stefanofinetti/MF_A320_Tiller/docs/img/button_heart.png

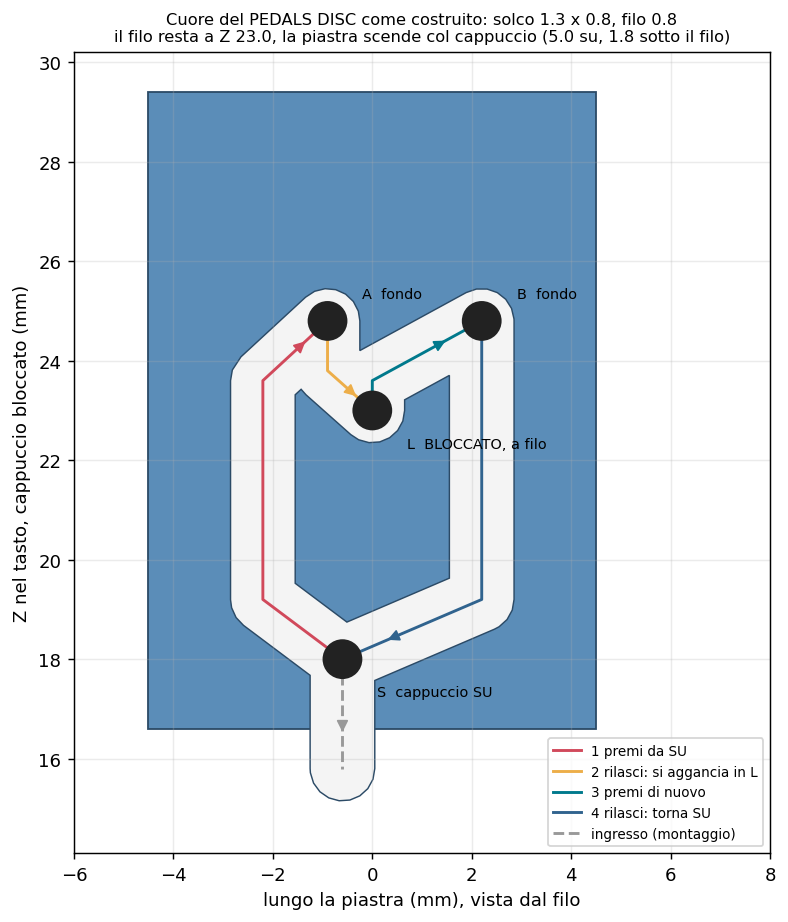
docs/img/button_heart.png
