stefanofinetti/MF_A320_Tiller/docs/img/button_legend.png

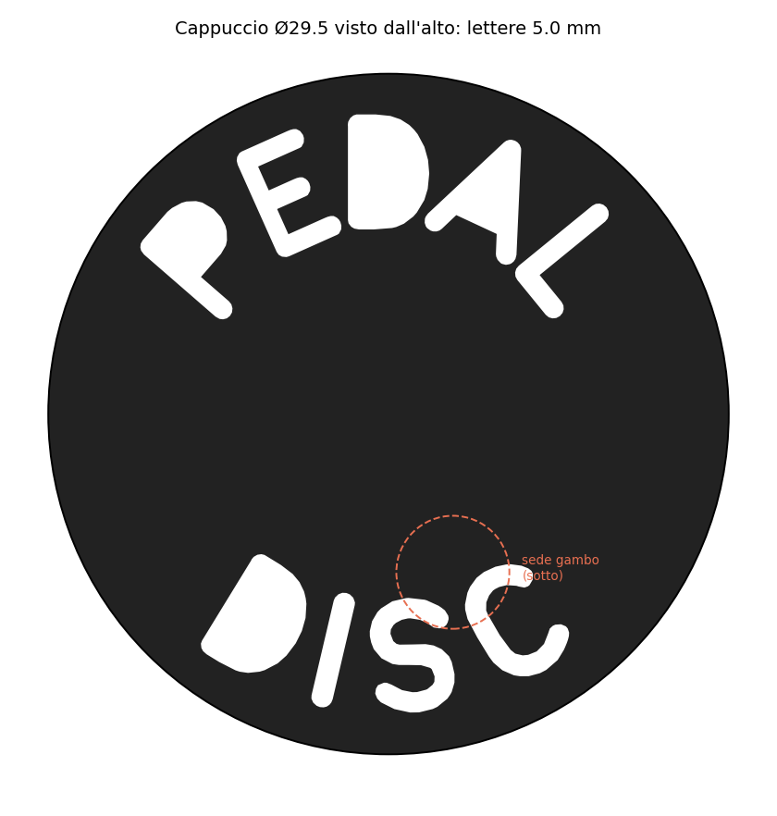
docs/img/button_legend.png
