stefanofinetti/MF_A320_Tiller/docs/img/button_switch.png

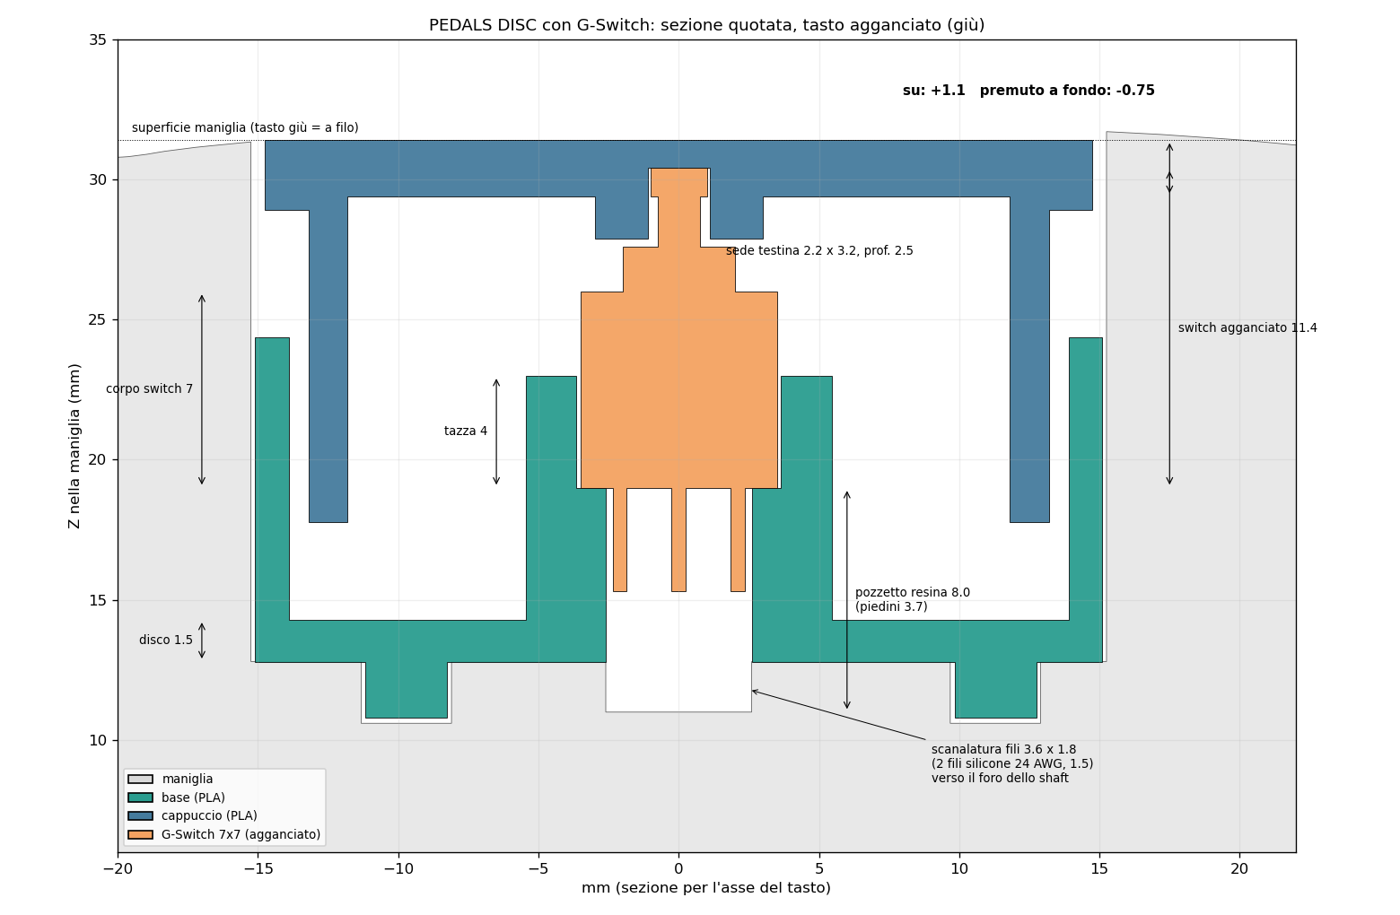
docs/img/button_switch.png
