stefanofinetti/MF_A320_Tiller/docs/img/case_layout_top.png

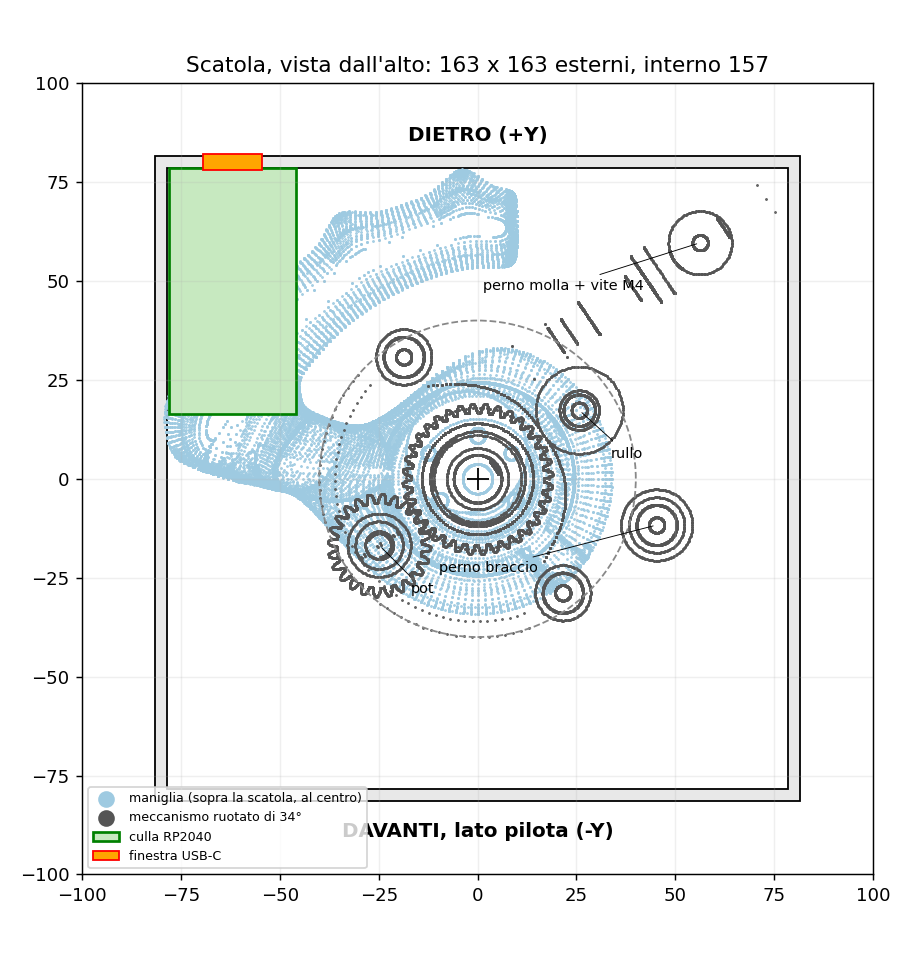
docs/img/case_layout_top.png
