stefanofinetti/MF_A320_Tiller/docs/img/case_sections.png

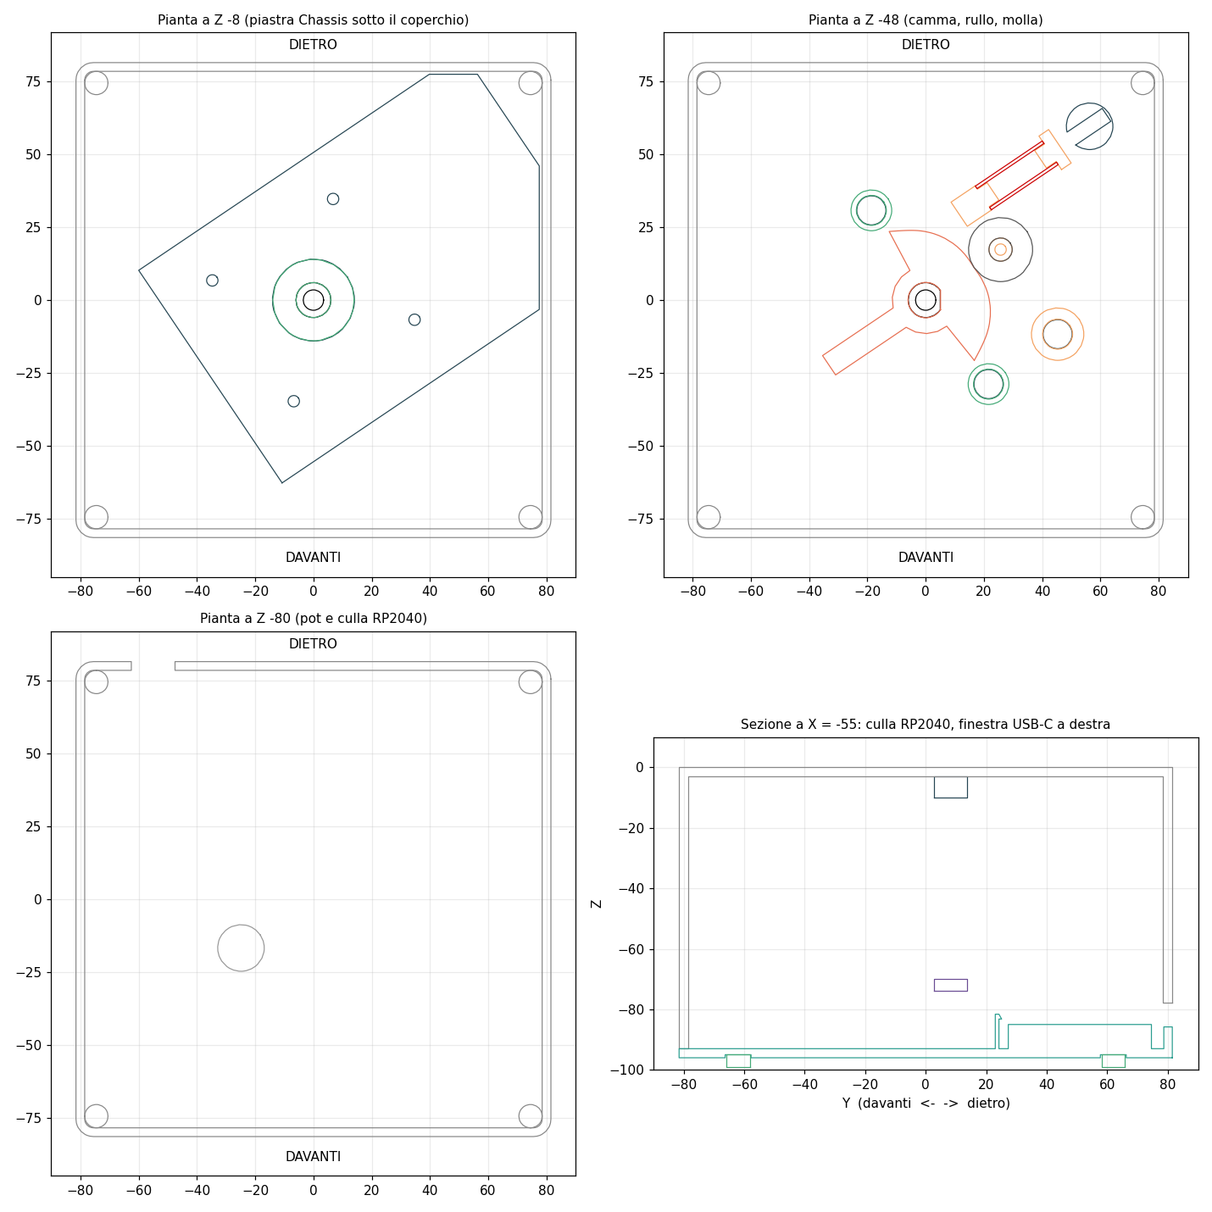
docs/img/case_sections.png
