stefanofinetti/MF_A320_Tiller/docs/img/IMG_1014.jpg

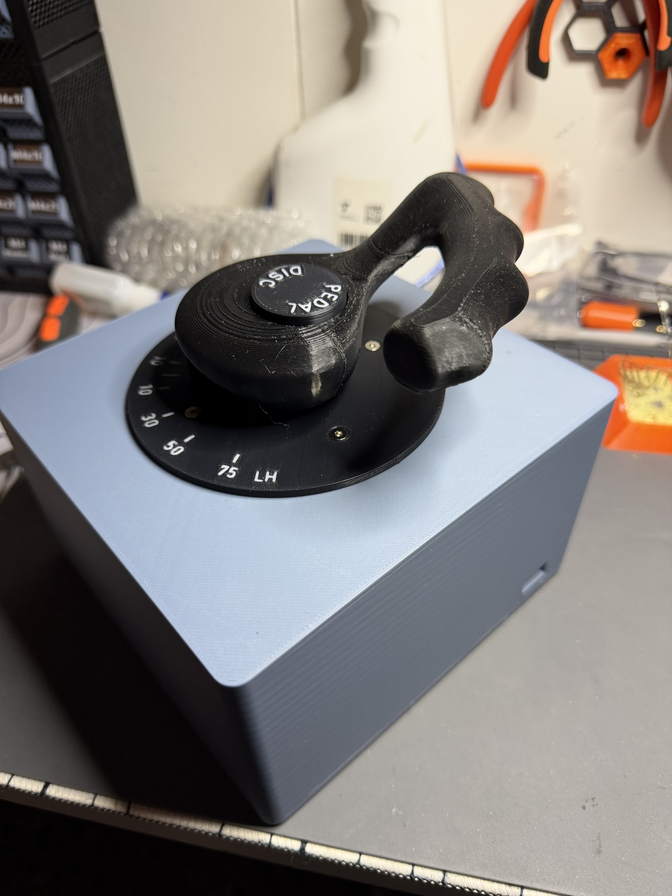
docs/img/IMG_1014.jpg
