stefanofinetti/MF_A320_Tiller/docs/img/mechanism_v2.png

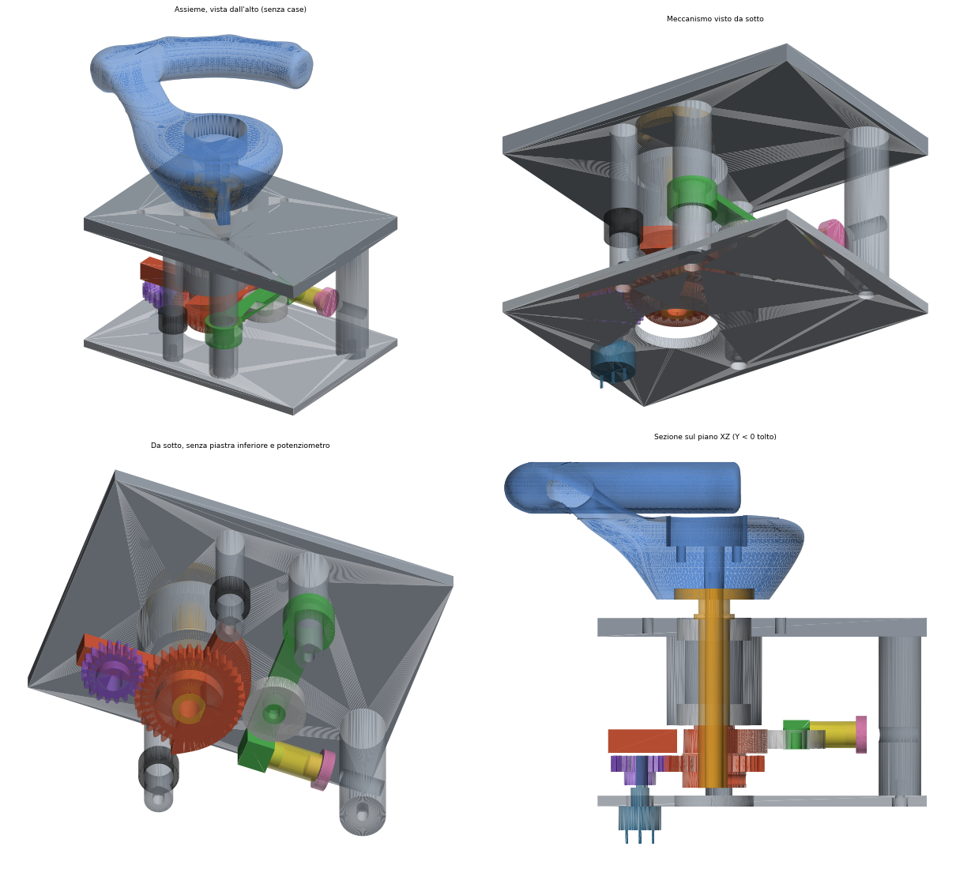
docs/img/mechanism_v2.png
