stefanofinetti/MF_A320_Tiller/docs/img/roller_pin.png

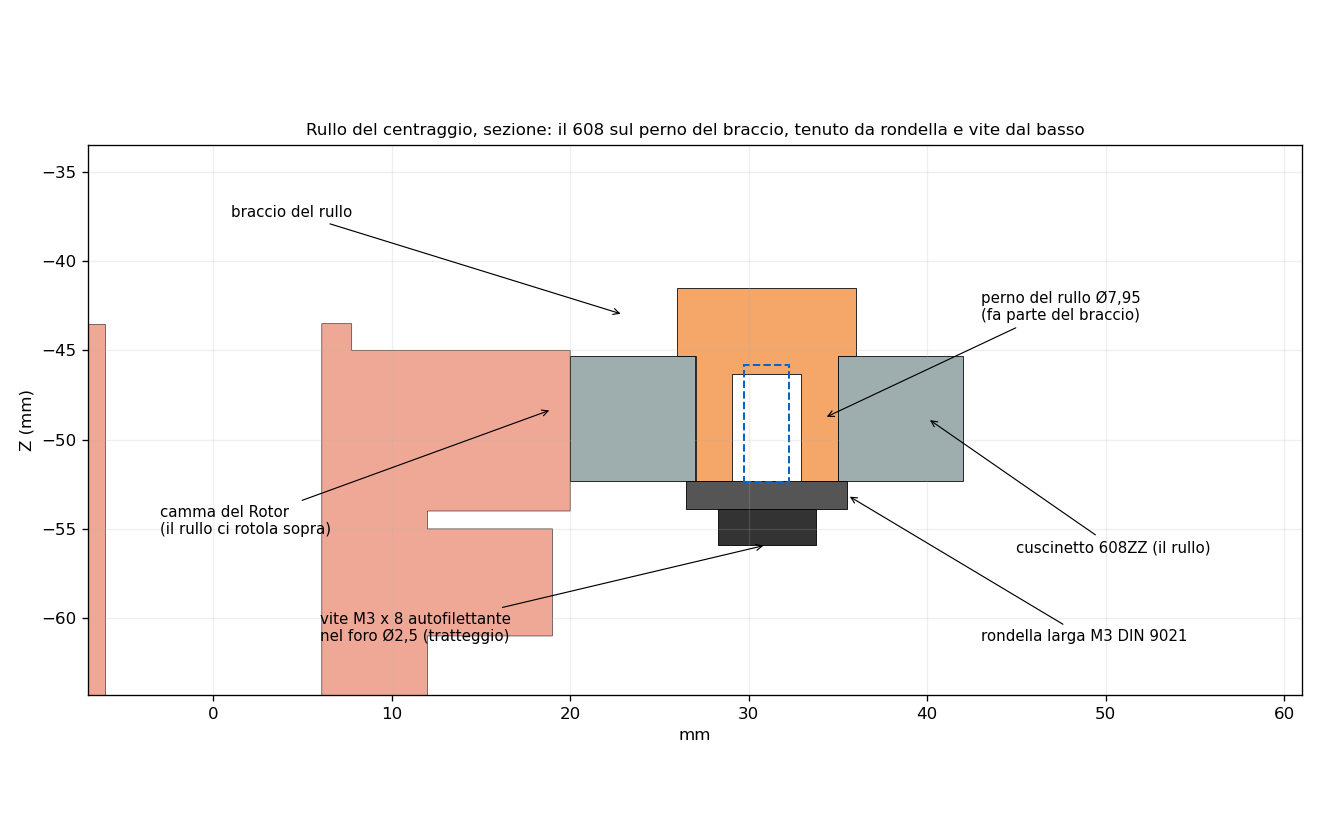
docs/img/roller_pin.png
