stefanofinetti/MF_A320_Tiller/docs/img/scale_disc.png

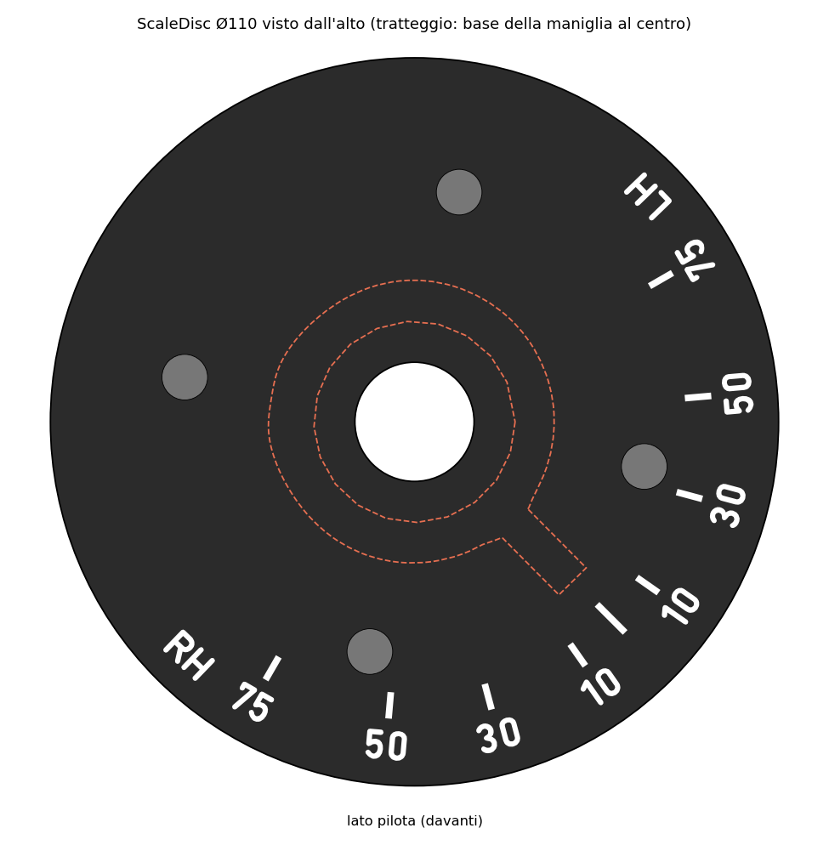
docs/img/scale_disc.png
