stefanofinetti/MF_A320_Tiller/cad/Hardware.FCStd

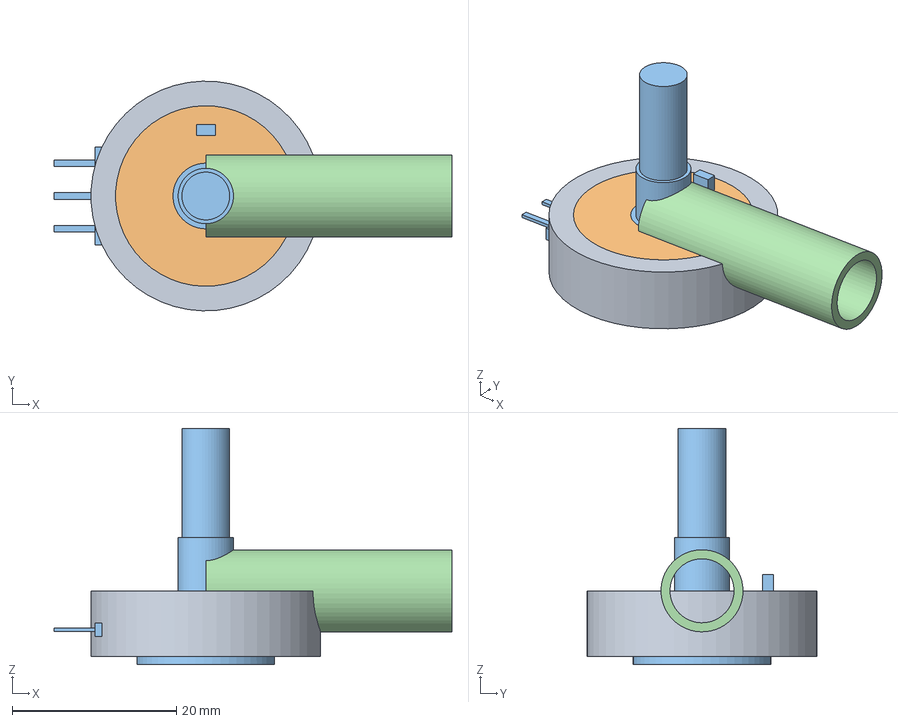
[picture p12: CAD file, 2026-11-09]
cad/Hardware.FCStd
48.5 x 28.0 x 28.8 mm
Bearing6001
Bearing608
Pot
Spring
