stefanofinetti/MF_A320_Tiller/stl/Tiller-SpringCup.stl

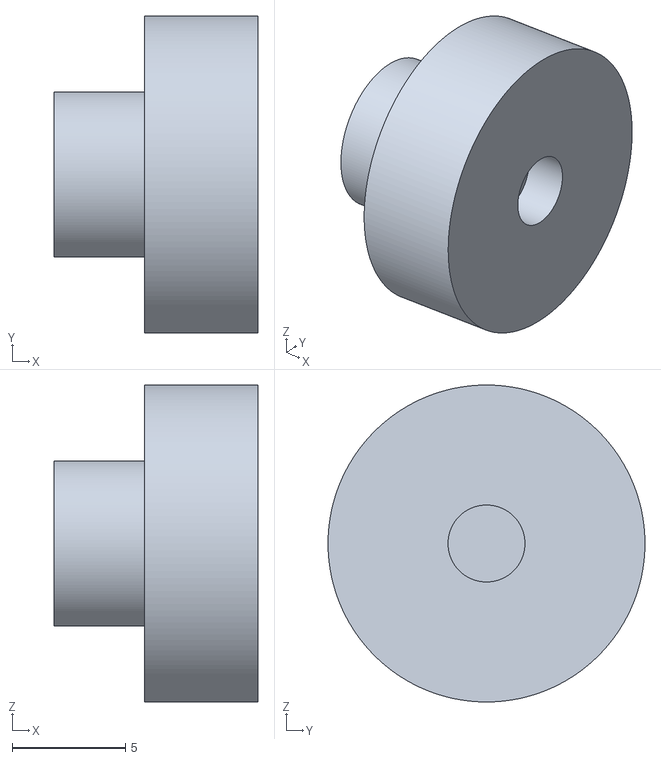
[picture p13: CAD file, 2026-11-09]
stl/Tiller-SpringCup.stl
9.00 x 14.0 x 14.0
