stefanofinetti/MF_A320_Tiller/cad/ScaleDisc.FCStd

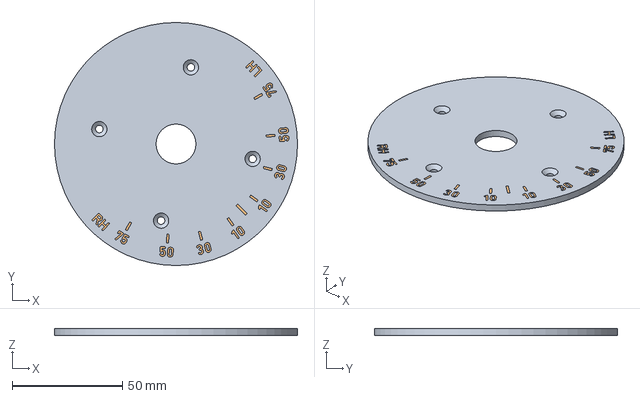
[picture p14: CAD file, 2026-11-09]
cad/ScaleDisc.FCStd
110.0 x 110.0 x 3.00 mm
ScaleDisc
ScaleDiscLegend
