stefanofinetti/MF_A320_Tiller/stl/Tiller-ButtonBase.stl

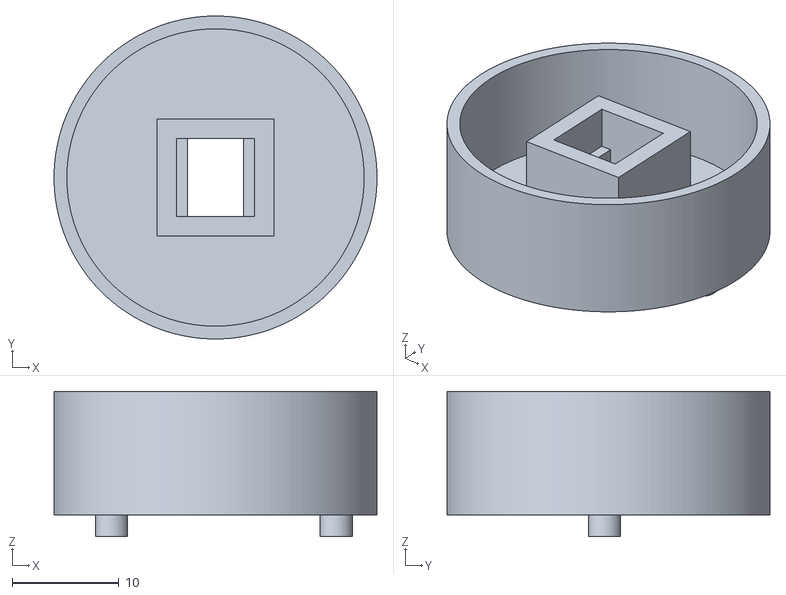
[picture p15: CAD file, 2026-11-09]
stl/Tiller-ButtonBase.stl
30.2 x 30.2 x 13.6
