stefanofinetti/MF_A320_Tiller/cad/ButtonBase.FCStd

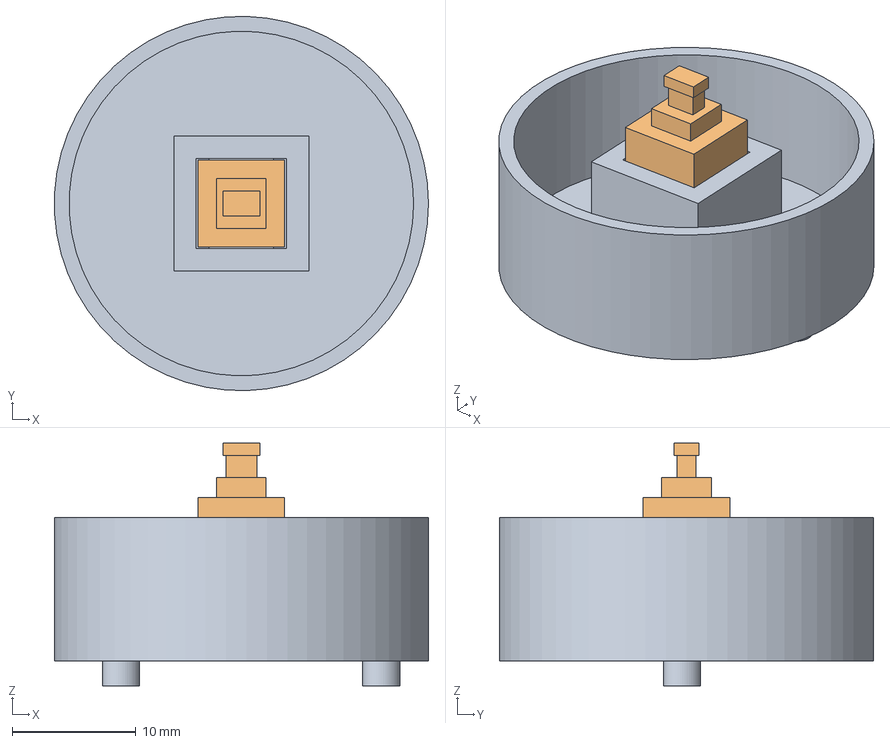
[picture p16: CAD file, 2026-11-09]
cad/ButtonBase.FCStd
30.2 x 30.2 x 19.6 mm
ButtonBase
Switch
