stefanofinetti/MF_A320_Tiller/stl/Tiller-CaseBottom.stl

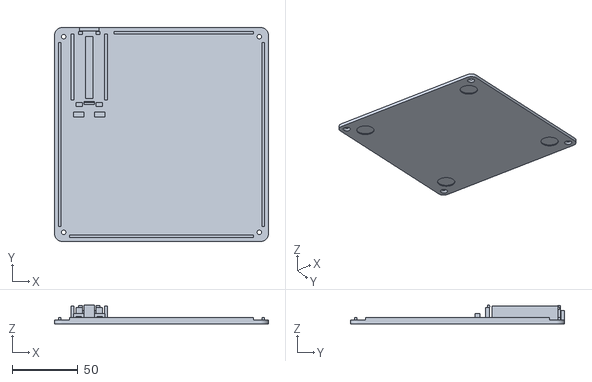
[picture p17: CAD file, 2026-11-09]
stl/Tiller-CaseBottom.stl
163.0 x 163.0 x 14.4
