stefanofinetti/MF_A320_Tiller/cad/Chassis.FCStd

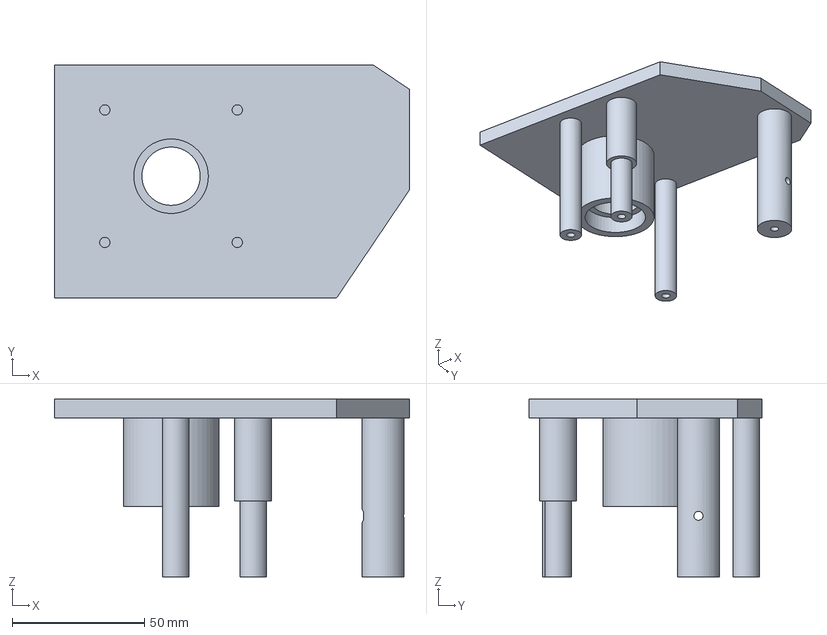
[picture p18: CAD file, 2026-11-09]
cad/Chassis.FCStd
134.0 x 88.0 x 67.0 mm
