stefanofinetti/MF_A320_Tiller/stl/Tiller-Handle.stl

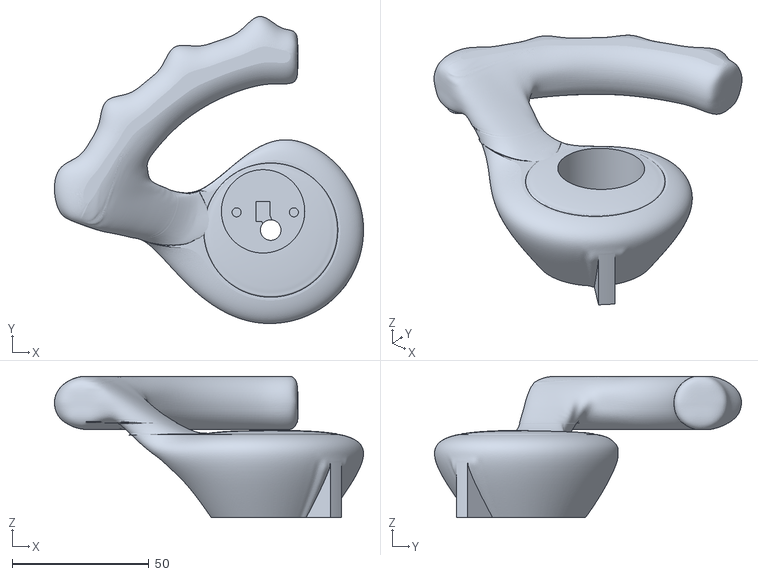
[picture p19: CAD file, 2026-11-09]
stl/Tiller-Handle.stl
113.1 x 112.4 x 51.8
