stefanofinetti/MF_A320_Tiller/cad/Bumper.FCStd

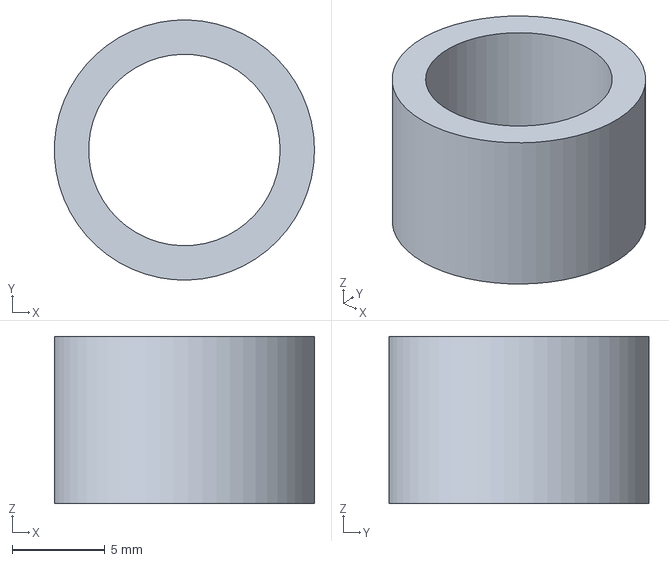
[picture p20: CAD file, 2026-11-09]
cad/Bumper.FCStd
14.0 x 14.0 x 9.00 mm
