stefanofinetti/MF_A320_Tiller/stl/Tiller-RollerArm.stl

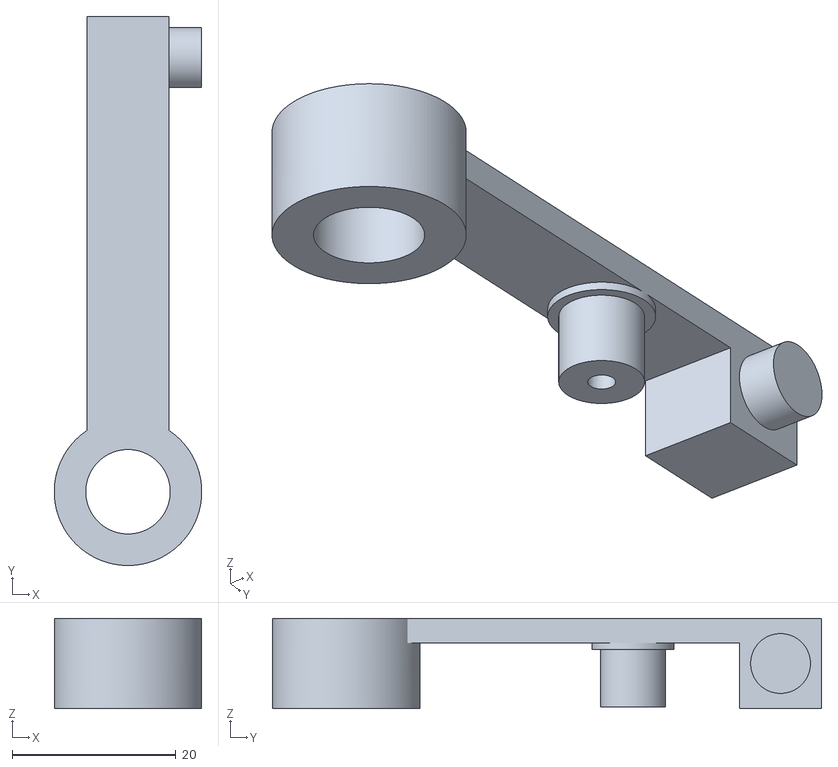
[picture p21: CAD file, 2026-11-09]
stl/Tiller-RollerArm.stl
18.0 x 67.0 x 11.0
