stefanofinetti/MF_A320_Tiller/cad/Shaft.FCStd

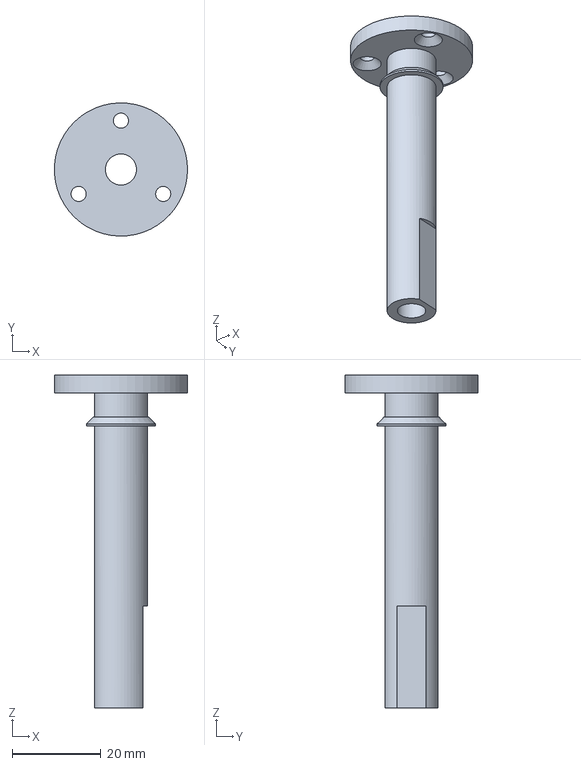
[picture p22: CAD file, 2026-11-09]
cad/Shaft.FCStd
30.0 x 30.0 x 75.0 mm
