stefanofinetti/MF_A320_Tiller/stl/Tiller-StopSpacer.stl

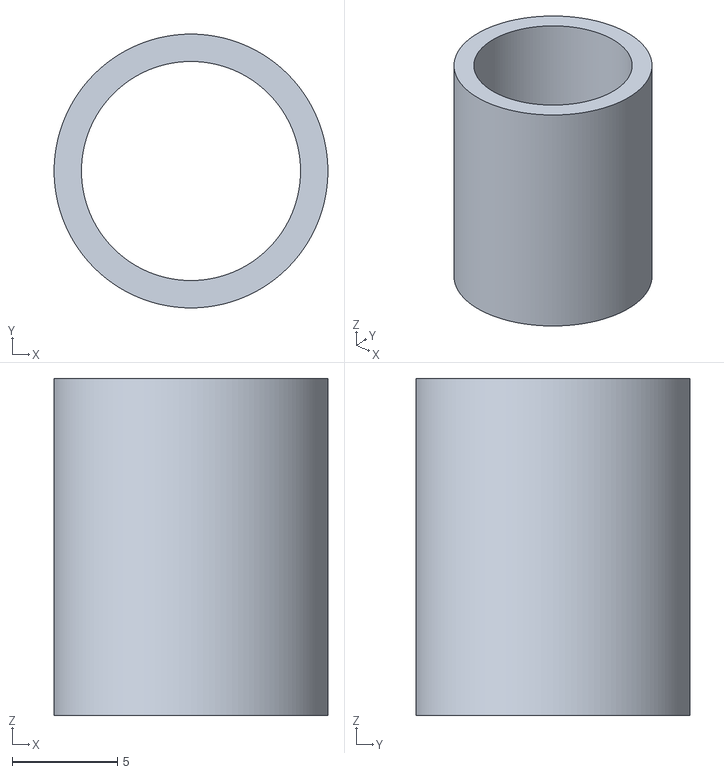
[picture p23: CAD file, 2026-11-09]
stl/Tiller-StopSpacer.stl
13.0 x 13.0 x 16.0
