stefanofinetti/MF_A320_Tiller/cad/Rotor.FCStd

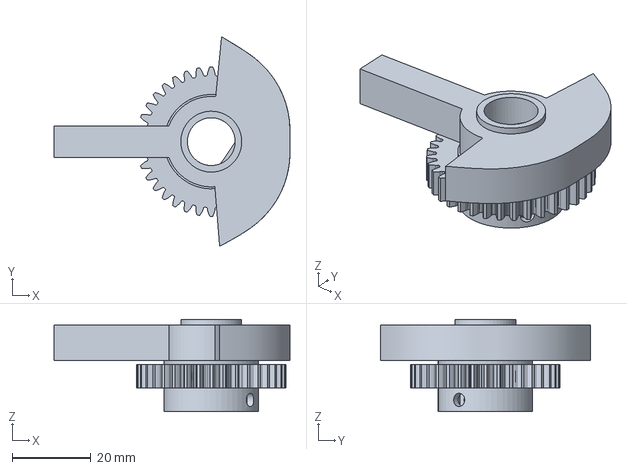
[picture p24: CAD file, 2026-11-09]
cad/Rotor.FCStd
60.0 x 53.3 x 23.5 mm
