stefanofinetti/MF_A320_Tiller/stl/Tiller-CaseShell.stl

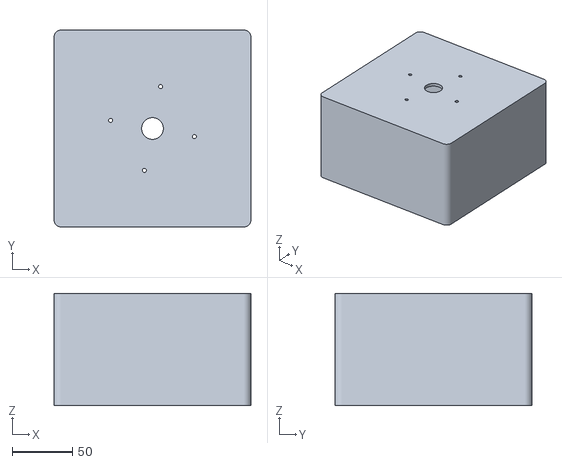
[picture p25: CAD file, 2026-11-09]
stl/Tiller-CaseShell.stl
163.0 x 163.0 x 93.0
