stefanofinetti/MF_A320_Tiller/stl/Tiller-Deck.stl

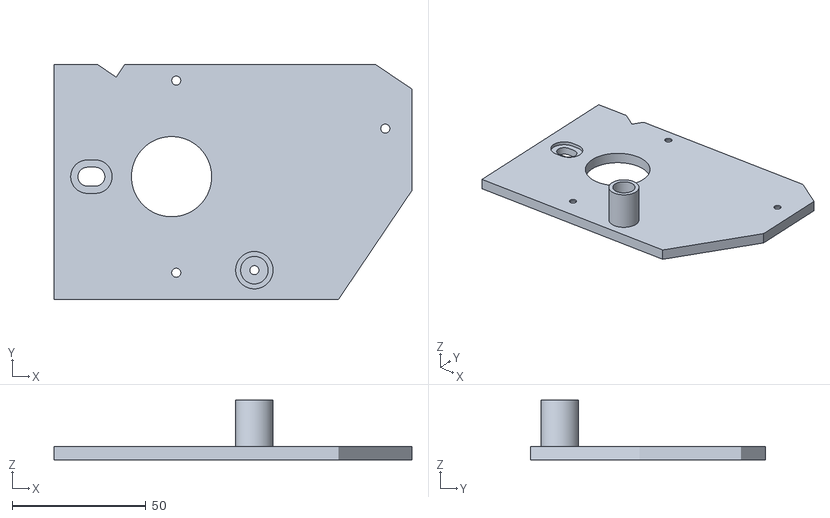
[picture p26: CAD file, 2026-11-09]
stl/Tiller-Deck.stl
134.0 x 88.0 x 22.4
