stefanofinetti/MF_A320_Tiller/cad/PotGear.FCStd

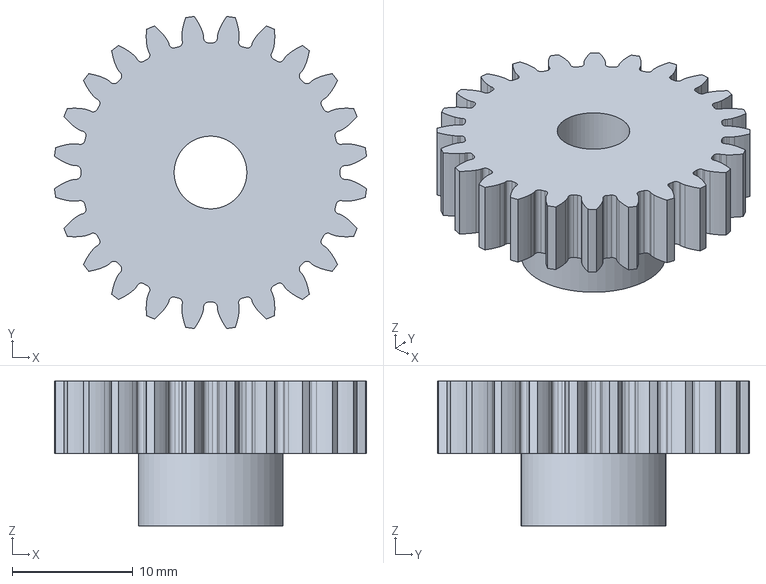
[picture p27: CAD file, 2026-11-09]
cad/PotGear.FCStd
25.9 x 25.9 x 12.0 mm
