stefanofinetti/MF_A320_Tiller/stl/FitTest-FitTest.stl

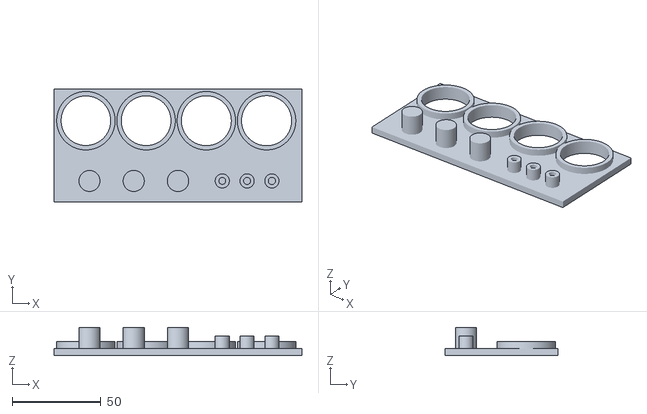
[picture p28: CAD file, 2026-11-09]
stl/FitTest-FitTest.stl
140.0 x 64.0 x 16.0
