stefanofinetti/MF_A320_Tiller/cad/Foot.FCStd

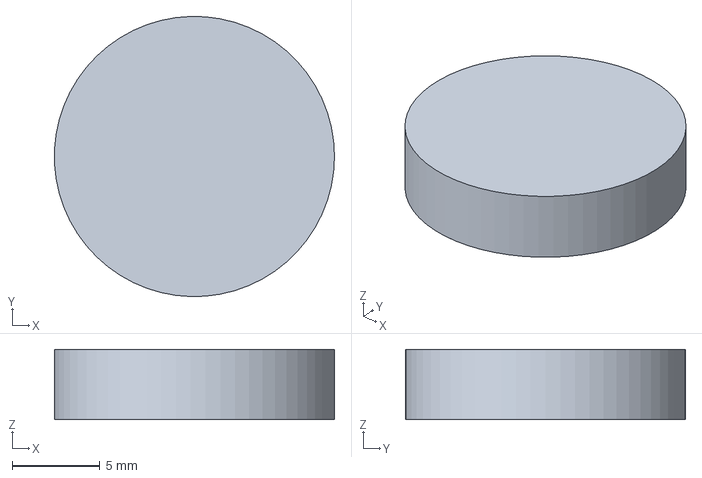
[picture p29: CAD file, 2026-11-09]
cad/Foot.FCStd
16.0 x 16.0 x 4.00 mm
