stefanofinetti/MF_A320_Tiller/stl/Tiller-ScaleDiscLegend.stl

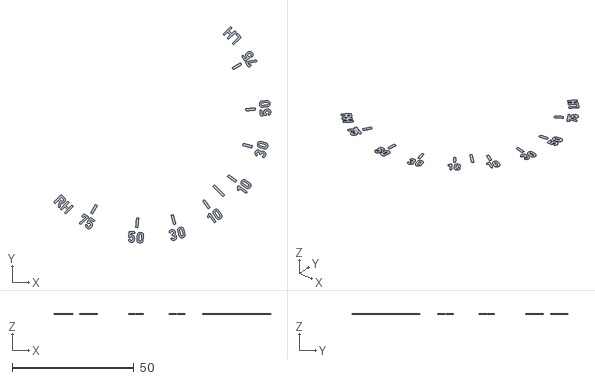
[picture p30: CAD file, 2026-11-09]
stl/Tiller-ScaleDiscLegend.stl
89.2 x 88.9 x 0.4
