stefanofinetti/MF_A320_Tiller/stl/Tiller-ButtonCapLegend.stl

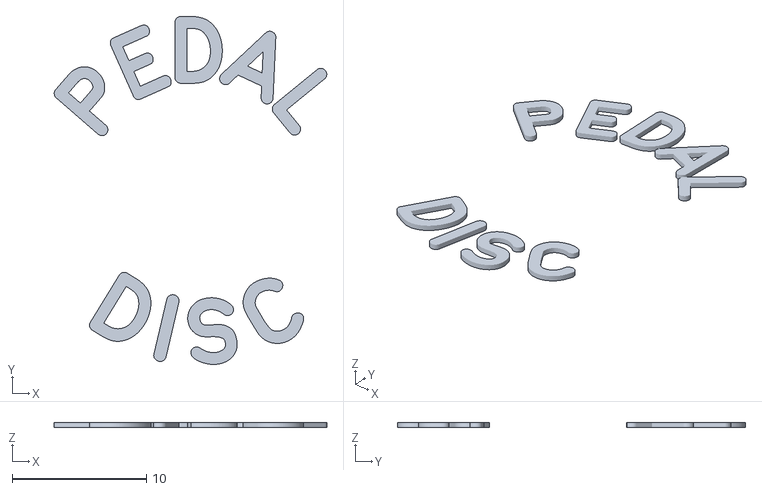
[picture p31: CAD file, 2026-11-09]
stl/Tiller-ButtonCapLegend.stl
20.3 x 25.9 x 0.4
