stefanofinetti/MF_A320_Tiller/stl/Tiller-ButtonCap.stl

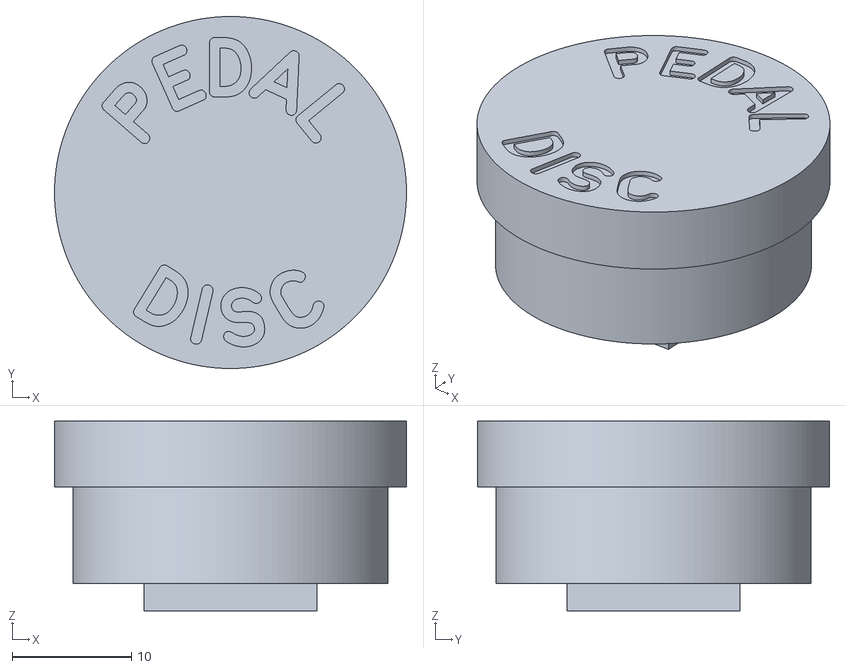
[picture p32: CAD file, 2026-11-09]
stl/Tiller-ButtonCap.stl
29.5 x 29.5 x 15.9
