stefanofinetti/MF_A320_Tiller/cad/FitTestPLA.FCStd

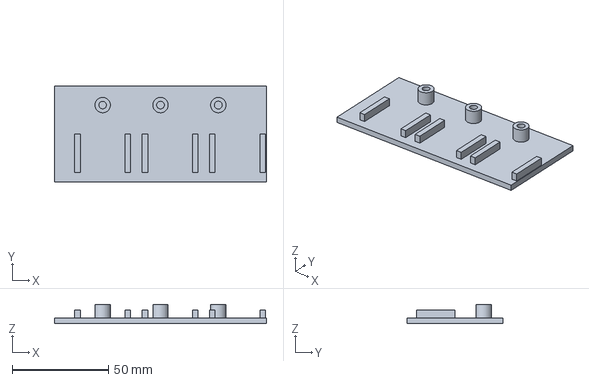
[picture p33: CAD file, 2026-11-09]
cad/FitTestPLA.FCStd
110.0 x 50.0 x 10.0 mm
