stefanofinetti/MF_A320_Tiller/cad/ButtonCap.FCStd

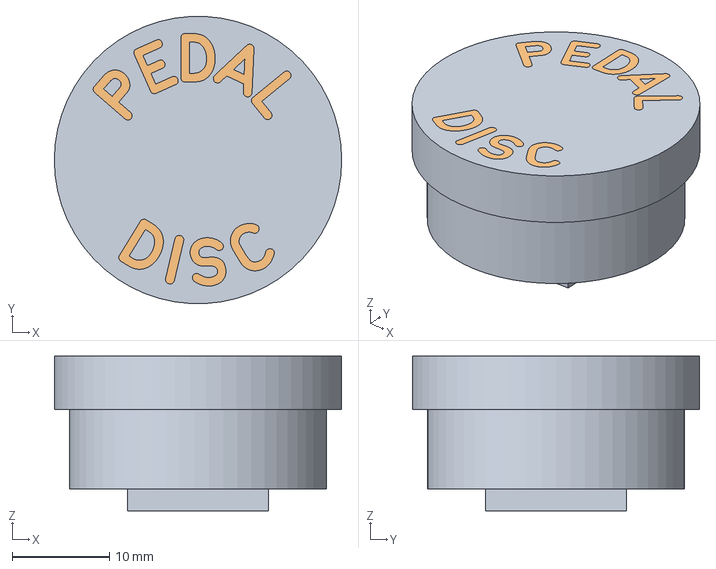
[picture p34: CAD file, 2026-11-09]
cad/ButtonCap.FCStd
29.5 x 29.5 x 15.9 mm
ButtonCap
ButtonCapLegend
