stefanofinetti/MF_A320_Tiller/(list of files, cad)

Other CAD files:
cad/Tiller.FCStd
stl/Tiller-Chassis.stl
cad/Handle.FCStd
cad/SpringCup.FCStd
stl/Tiller-ScaleDisc.stl
cad/RollerArm.FCStd
stl/Tiller-Shaft.stl
cad/StopSpacer.FCStd
stl/Tiller-PotGear.stl
cad/CaseBottom.FCStd
cad/Deck.FCStd
stl/Tiller-Rotor.stl
cad/CaseShell.FCStd
stl/Tiller-Foot.stl
cad/FitTest.FCStd
stl/FitTestPLA-FitTestPLA.stl
stl/Tiller-Bumper.stl
